VanessaHanna05/Moving-Chair-Robot/README.md

# Moving-Chair-Robot
A chair that is activated by a clap and returns to its designated location under the desk.
The main language used is C++ and some Python.
The controllers adapted were Arduino Mega and Arduino UNO.
The localization algorithm was studies for both BLE beacons and WIFI strength but the WIFI was adapted in the implementation.
A detailed report can be found in the file.
